fickel0/scoreboard/pcb/scoreboard/scoreboard.kicad_pcb

## KiCad design pcb/scoreboard/scoreboard.kicad_pcb (2024-07-22)

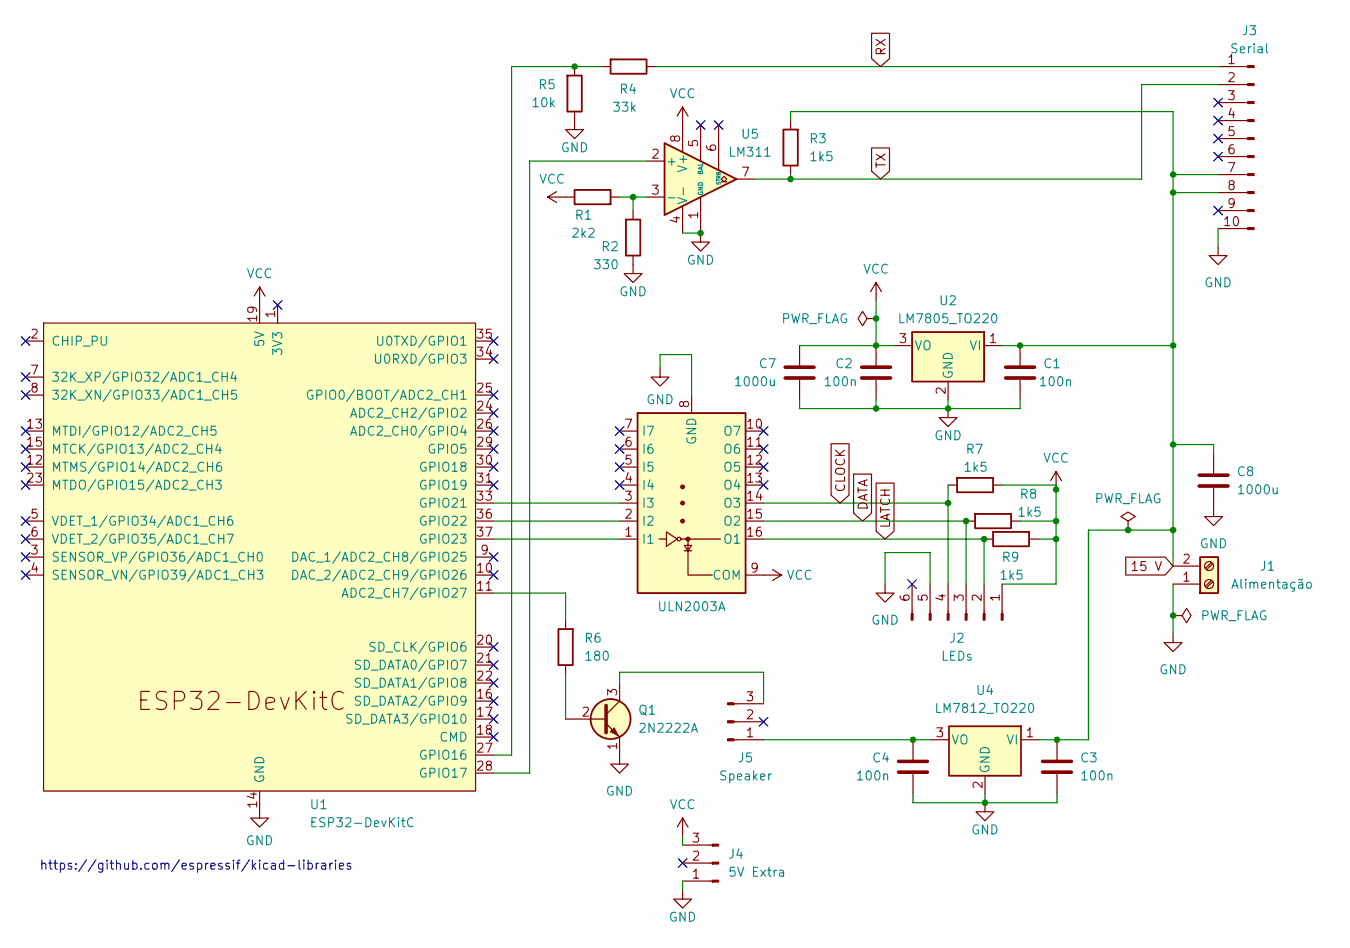
[picture p1: schematic scoreboard.kicad_sch]

Parts:
C1, C2, C3, C4: 100n; C_Disc_D5.0mm_W2.5mm_P2.50mm
C7, C8: 1000u; C_Radial_D8.0mm_H11.5mm_P3.50mm
J1: Alimentação; TerminalBlock_Altech_AK300-2_P5.00mm
J2: LEDs; PinHeader_1x06_P2.54mm_Vertical
J3: Serial; PinHeader_2x05_P2.54mm_Vertical
J4: 5V Extra; PinHeader_1x03_P2.54mm_Vertical
J5: Speaker; PinHeader_1x03_P2.54mm_Vertical
Q1: 2N2222A; TO-92_EBC
R1: 2k2; R_Axial_DIN0204_L3.6mm_D1.6mm_P7.62mm_Horizontal
R2: 330; R_Axial_DIN0204_L3.6mm_D1.6mm_P7.62mm_Horizontal
R3, R7: 1k5; R_Axial_DIN0204_L3.6mm_D1.6mm_P7.62mm_Horizontal
R4: 33k; R_Axial_DIN0204_L3.6mm_D1.6mm_P7.62mm_Horizontal
R5: 10k; R_Axial_DIN0204_L3.6mm_D1.6mm_P7.62mm_Horizontal
R6: 180; R_Axial_DIN0204_L3.6mm_D1.6mm_P10.16mm_Horizontal
R8, R9: 1k5; R_Axial_DIN0204_L3.6mm_D1.6mm_P5.08mm_Horizontal
U1: ESP32-DevKitC
U2: LM7805_TO220; TO-220-3_Vertical
U3: ULN2003A; DIP-16_W7.62mm_LongPads
U4: LM7812_TO220; TO-220-3_Vertical
U5: LM311; DIP-8_W7.62mm_LongPads

Connections:
15 V: C1.1, C3.1, C8.1, J1.2, J3.7, J3.8, R3.2, U2.1 (VI), U4.1 (VI)
CLOCK: J2.4, R7.2, U3.14 (O3)
DATA: J2.3, R8.2, U3.15 (O2)
GND: C1.2, C2.2, C3.2, C4.2, C7.2, C8.2, J1.1, J2.5, J3.10, J4.1, Q1.1 (E), R2.1, R5.1, U1.14 (GND), U1.32 (GND), U1.38 (GND), U2.2 (GND), U3.8 (GND), U4.2 (GND), U5.1 (GND), U5.4 (V-)
LATCH: J2.2, R9.2, U3.16 (O1)
unnamed: C4.1, J5.1, U4.3 (VO)
unnamed: J5.3, Q1.3 (C)
unnamed: Q1.2 (B), R6.1
unnamed: R6.2, U1.11 (ADC2_CH7/GPIO27)
unnamed: R4.2, R5.2, U1.27 (GPIO16)
unnamed: U1.28 (GPIO17), U5.2 (+)
unnamed: U1.33 (GPIO21), U3.3 (I3)
unnamed: U1.36 (GPIO22), U3.2 (I2)
unnamed: U1.37 (GPIO23), U3.1 (I1)
unnamed: R1.2, R2.2, U5.3 (-)
RX: J3.1, R4.1
TX: J3.2, R3.1, U5.7
VCC: C2.1, C7.1, J2.1, J4.3, R1.1, R7.1, R8.1, R9.1, U1.19 (5V), U2.3 (VO), U3.9 (COM), U5.8 (V+)

Notes on the sheet:
https://github.com/espressif/kicad-libraries

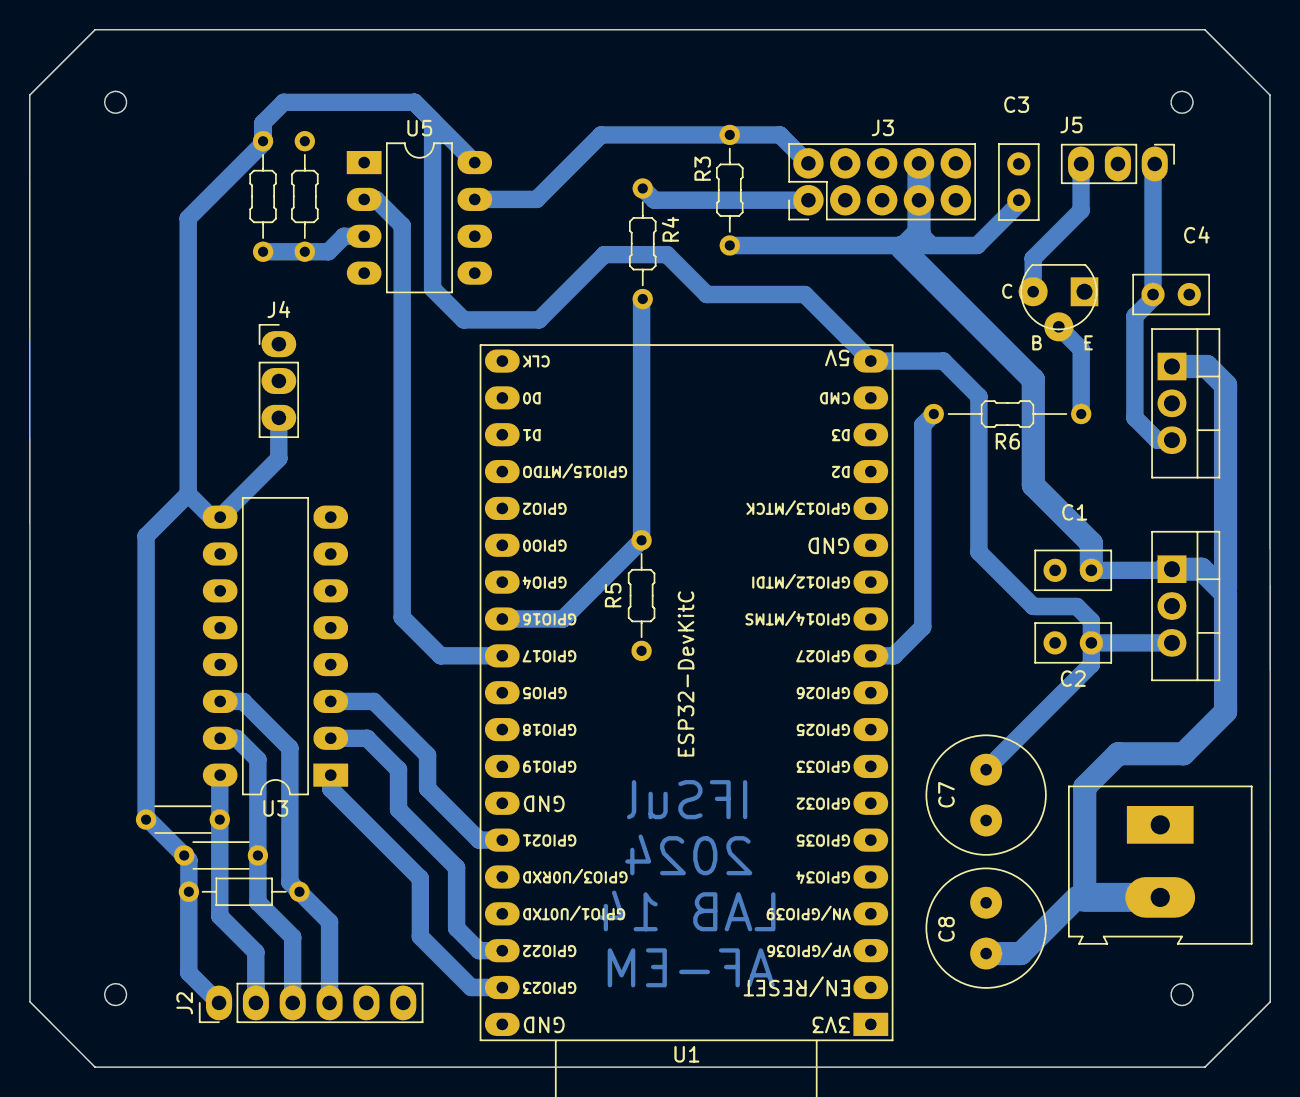
[picture p2: board scoreboard.kicad_pcb from above]

Board: 2 copper layers, 85.5 x 71.5 mm, 26 parts (0 on the bottom side), 18 nets.
