fickel0/scoreboard/pcb/controller/controller.kicad_pcb

## KiCad design pcb/controller/controller.kicad_pcb (2024-07-22)

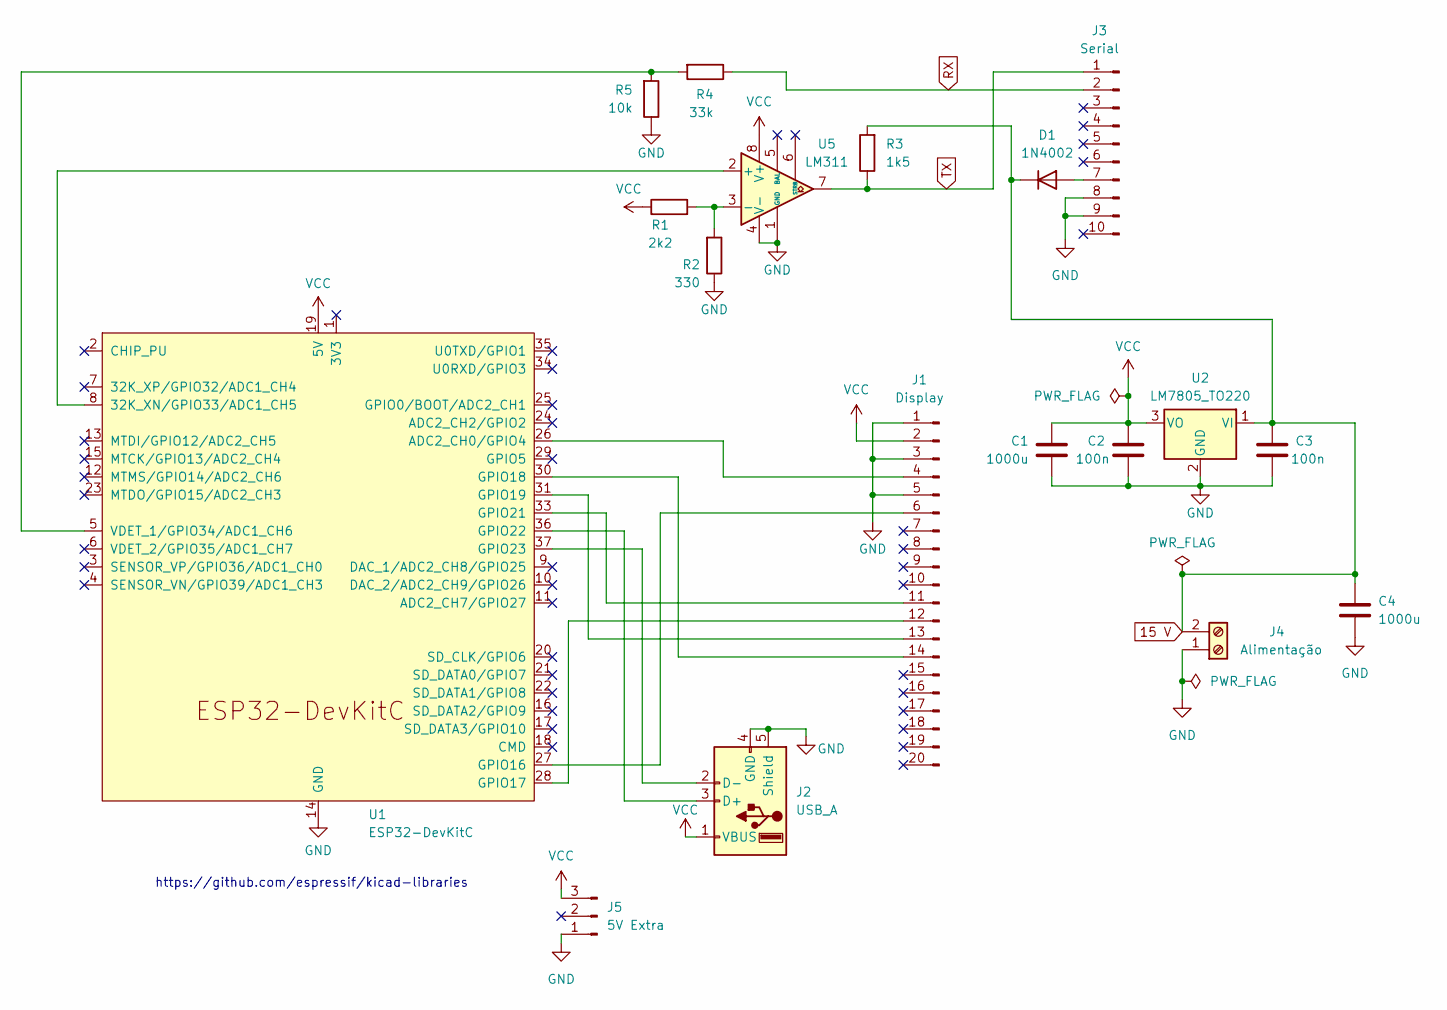
[picture p3: schematic controller.kicad_sch]

Parts:
C1, C4: 1000u; C_Radial_D8.0mm_H11.5mm_P3.50mm
C2, C3: 100n; C_Disc_D5.0mm_W2.5mm_P2.50mm
D1: 1N4002; D_DO-41_SOD81_P10.16mm_Horizontal
J1: Display; PinHeader_2x10_P2.54mm_Vertical
J2: USB_A; USB_A_Wuerth_614004134726_Horizontal
J3: Serial; PinHeader_2x05_P2.54mm_Vertical
J4: Alimentação; TerminalBlock_Altech_AK300-2_P5.00mm
J5: 5V Extra; PinHeader_1x03_P2.54mm_Vertical
R1: 2k2; R_Axial_DIN0204_L3.6mm_D1.6mm_P7.62mm_Horizontal
R2: 330; R_Axial_DIN0204_L3.6mm_D1.6mm_P7.62mm_Horizontal
R3: 1k5; R_Axial_DIN0204_L3.6mm_D1.6mm_P7.62mm_Horizontal
R4: 33k; R_Axial_DIN0204_L3.6mm_D1.6mm_P7.62mm_Horizontal
R5: 10k; R_Axial_DIN0204_L3.6mm_D1.6mm_P7.62mm_Horizontal
U1: ESP32-DevKitC
U2: LM7805_TO220; TO-220-3_Vertical
U5: LM311; DIP-8_W7.62mm_LongPads

Connections:
15 V: C3.1, C4.1, D1.1 (K), J4.2, R3.2, U2.1 (VI)
GND: C1.2, C2.2, C3.2, C4.2, J1.1, J1.3, J1.5, J2.4 (GND), J2.5 (Shield), J3.8, J3.9, J4.1, J5.1, R2.1, R5.1, U1.14 (GND), U1.32 (GND), U1.38 (GND), U2.2 (GND), U5.1 (GND), U5.4 (V-)
unnamed: D1.2 (A), J3.7
unnamed: J1.4, U1.26 (ADC2_CH0/GPIO4)
unnamed: J1.6, U1.27 (GPIO16)
unnamed: J1.11, U1.33 (GPIO21)
unnamed: J1.12, U1.28 (GPIO17)
unnamed: J1.13, U1.31 (GPIO19)
unnamed: J1.14, U1.30 (GPIO18)
unnamed: J2.3 (D+), U1.36 (GPIO22)
unnamed: J2.2 (D-), U1.37 (GPIO23)
unnamed: U1.8 (32K_XN/GPIO33/ADC1_CH5), U5.2 (+)
unnamed: R4.2, R5.2, U1.5 (VDET_1/GPIO34/ADC1_CH6)
unnamed: R1.2, R2.2, U5.3 (-)
RX: J3.2, R4.1
TX: J3.1, R3.1, U5.7
VCC: C1.1, C2.1, J1.2, J2.1 (VBUS), J5.3, R1.1, U1.19 (5V), U2.3 (VO), U5.8 (V+)

Notes on the sheet:
https://github.com/espressif/kicad-libraries

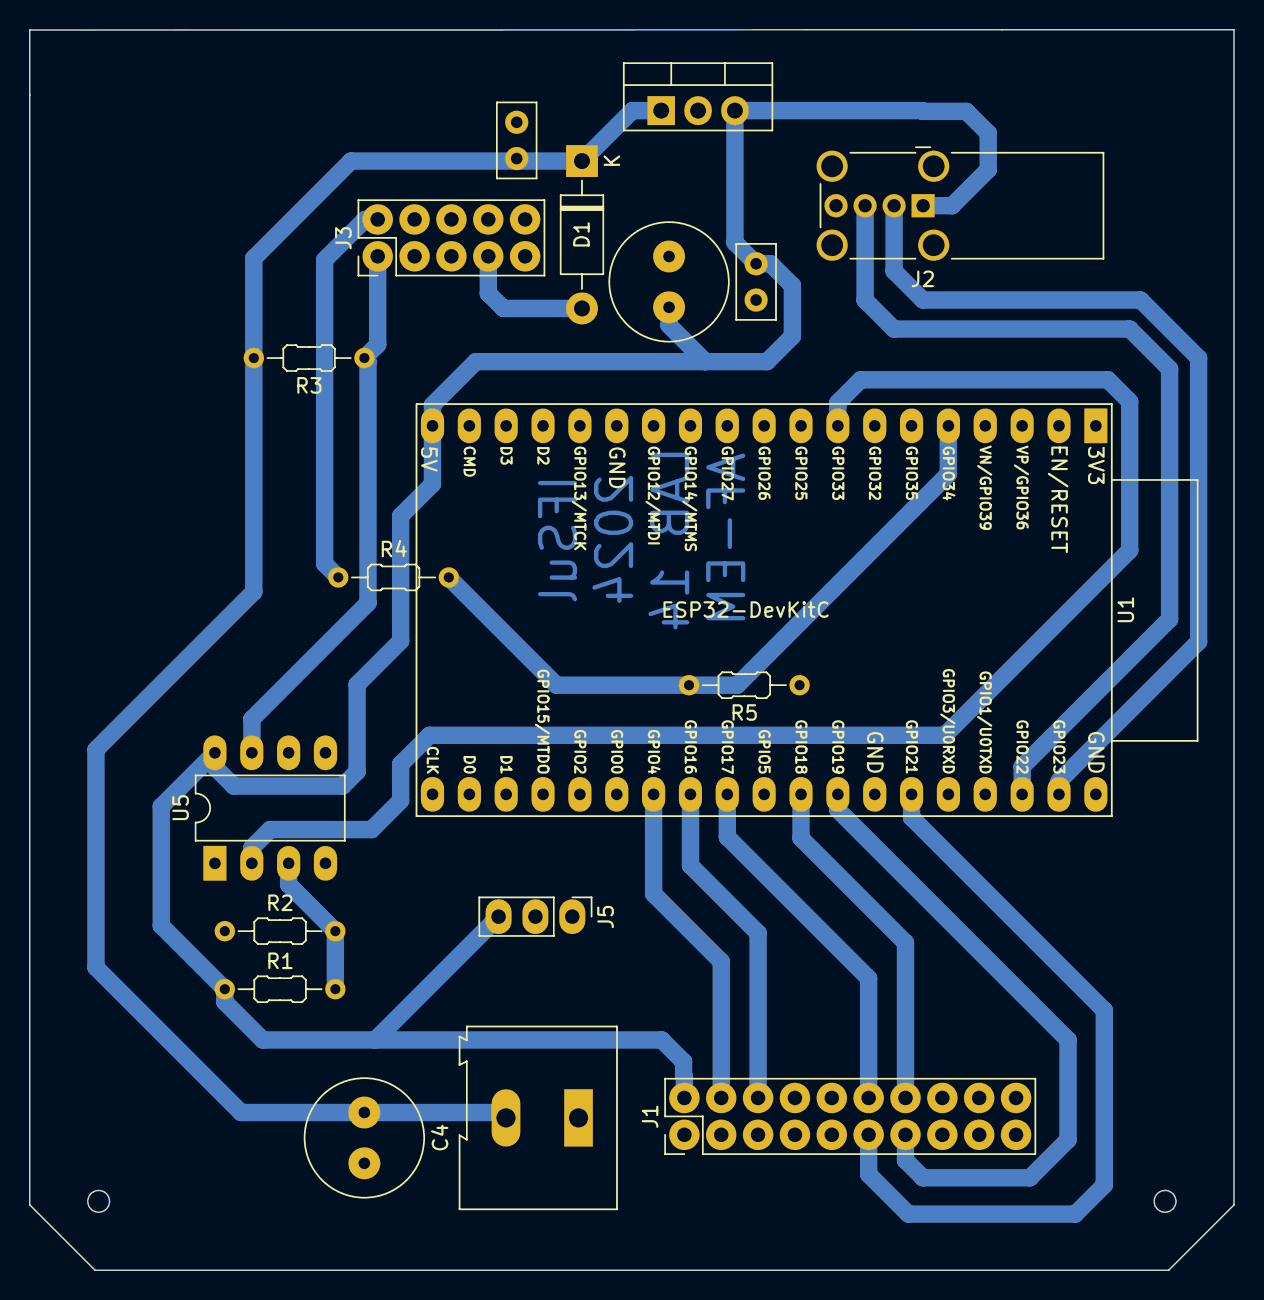
[picture p4: board controller.kicad_pcb from above]

Board: 2 copper layers, 83.0 x 85.5 mm, 18 parts (0 on the bottom side), 17 nets.
